open-vela/contest2026_438_baimi/evidence/IMG20260917205952.jpg

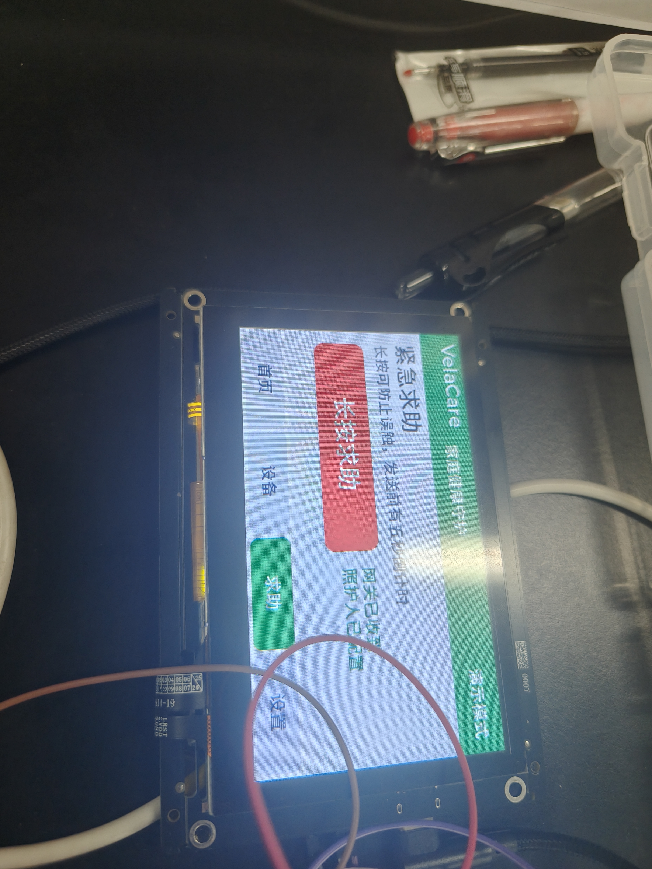
evidence/IMG20260917205952.jpg
