open-vela/contest2026_438_baimi/evidence/IMG20260917205958.jpg

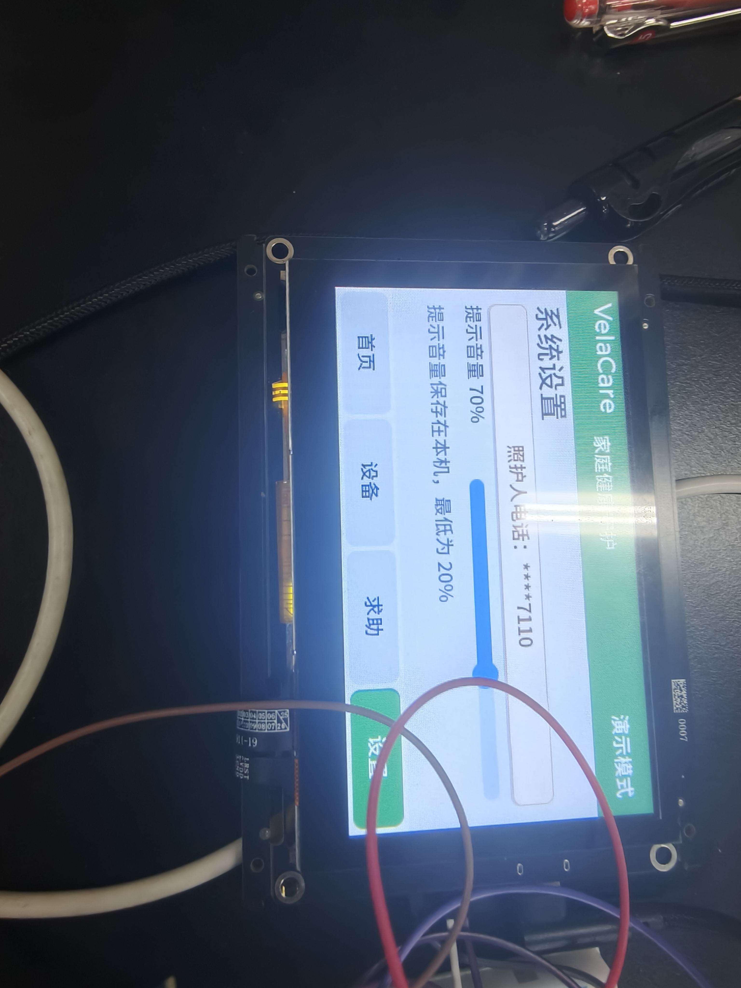
evidence/IMG20260917205958.jpg
