open-vela/contest2026_438_baimi/evidence/README.md

# 真机证据

这里只放少量实拍，避免把所有原图堆进仓库。

- `IMG20260916125602.jpg` — ESP32 与喇叭/传感器接线
- `IMG20260917205952.jpg`、`IMG20260917205958.jpg` — D12X 求助/设置相关实拍
- `Snipaste_2026-08-29_*.png` — 早期板卡界面，不是 9 月成品多角度照

完整系统接线、D12X 界面、传感器触发和网关联动过程已在演示视频中展示，链接见仓库根目录 `演示视频说明.md`。
