open-vela/contest2026_438_baimi/演示视频说明.md

# VelaCare 演示视频

## 📹 视频信息

- **文件名**：VelaCare_演示视频_Team438_baimi.zip
- **文件大小**：667.65 MB
- **格式**：MP4 (压缩包)
- **时长**：约 5 分钟
- **拍摄日期**：2026-09-19

## 🔗 下载链接

由于视频文件较大（667MB），超过 GitHub 单文件 100MB 限制，我们已将演示视频上传至百度网盘。

**百度网盘链接**：[https://pan.baidu.com/s/1Zz3T1Osgljr5gFPIG-S2Kg?pwd=6f4v](https://pan.baidu.com/s/1Zz3T1Osgljr5gFPIG-S2Kg?pwd=6f4v)

**提取码**：6f4v

## 📝 视频内容

演示视频完整展示了 VelaCare 家庭健康守护系统的以下功能：

### 1. 系统概览
- D12X 主界面展示
- 网关 Web 界面操作
- 系统架构说明

### 2. 传感器实时监测
- **门磁传感器**：门窗开关检测与告警
- **跌倒传感器**：老人跌倒检测（MPU-6500/9250 IMU）
- **水浸传感器**：漏水检测与提醒
- **烟雾传感器**：火灾隐患监测

### 3. 智能告警功能
- 多级告警机制（普通/严重/持续未恢复）
- D12X 界面实时状态显示
- 蜂鸣器声音告警
- **AI 语音播报**：跌倒事件智能语音提醒
- 网关远程监控与确认

### 4. 人性化设计
- 老人友好的大字体界面
- 一键求助功能
- 语音关怀与提醒
- 告警确认与静音

### 5. 真机运行
- 所有传感器实际触发演示
- ESP32-S3 + MAX98357A 音频播放
- D12X-DEMO68 实时响应
- 网络通信稳定性展示

## 🛠️ 技术亮点

- **OpenVela RTOS**：D12X 主板运行 VelaCare 应用
- **ESP32-S3**：网关核心，处理多传感器数据
- **AI 语音合成**：跌倒事件智能播报（MAX98357A 功放 + 喇叭）
- **实时通信**：UART + HTTP 双通道
- **多级告警**：普通提醒 → 严重告警 → 持续未恢复

## 📊 硬件配置

详见 [README 中的当前真机接线表](README.md#4-接线当前真机)

- D12X-DEMO68-V1.2 主板
- ESP32-S3-DevKitC 开发板
- MPU-6500/9250 六轴陀螺仪（跌倒检测）
- 门磁传感器、水浸传感器、烟雾传感器
- MAX98357A I2S 音频功放 + 4Ω 3W 喇叭

## 👥 团队信息

- **队伍名称**：baimi
- **队伍编号**：438
- **参赛分支**：dev-ai-contest-2026

---

**注意**：如链接失效或下载遇到问题，请联系团队成员或查看 GitHub Issues。
