open-vela/contest2026_438_baimi/docs/demo-video.md

# 演示视频

演示视频已于 2026-09-19 完成，时长约 5 分钟。因压缩包为 667.65 MB，超过 GitHub 单文件限制，已上传至百度网盘。下载链接、提取码和完整说明见[《VelaCare 演示视频说明》](../演示视频说明.md)。视频覆盖：

1. D12X 四页与适老按钮
2. 门磁开合、跌倒触发与恢复
3. 蜂鸣器、ESP32 中文语音、家人网页确认/静音
4. 老人确认安全后，界面仍保持真实告警
5. 自建 Skill 与 AI Coding 协作说明（短）

仓库不重复存放大体积视频压缩包。
