open-vela/contest2026_438_baimi/app/velacare/README.md

# app/velacare

openvela / NuttX 应用，PROGNAME=`velacare`。

启用选项：`CONFIG_LVX_USE_DEMO_CONTEST2026_438_VELACARE`

映射：`app/velacare` -> `packages/demos/contest2026_438_velacare`
