open-vela/contest2026_438_baimi/evidence/IMG20260916125602.jpg

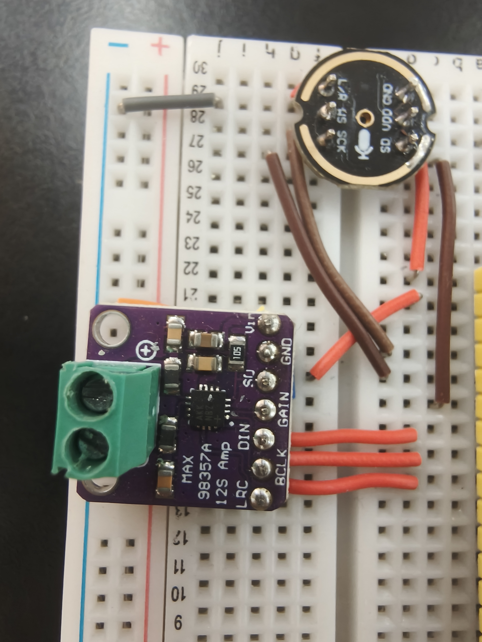
evidence/IMG20260916125602.jpg
