open-vela/contest2026_438_baimi/evidence/Snipaste_2026-08-29_14-42-14.png

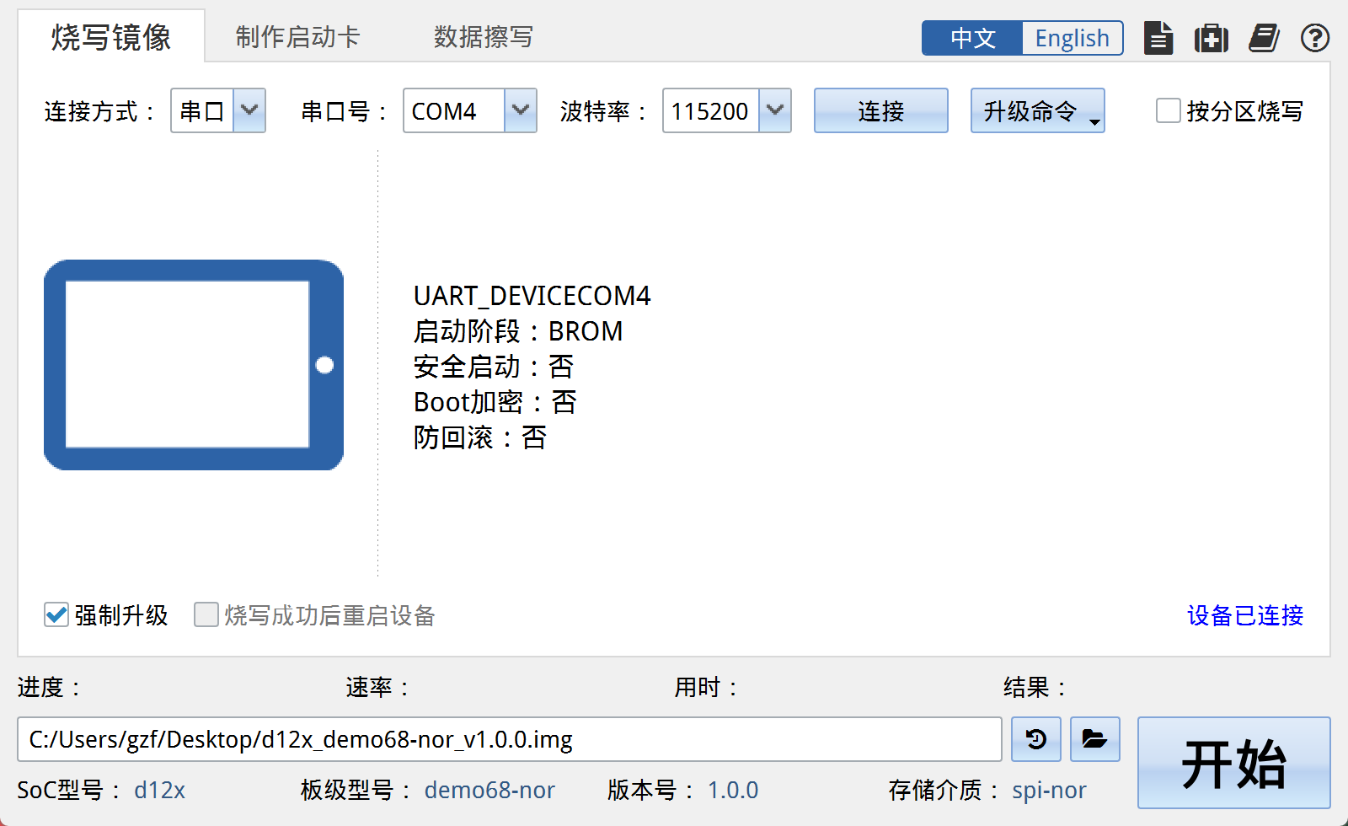
evidence/Snipaste_2026-08-29_14-42-14.png
