open-vela/contest2026_438_baimi/evidence/Snipaste_2026-08-29_17-33-11.png

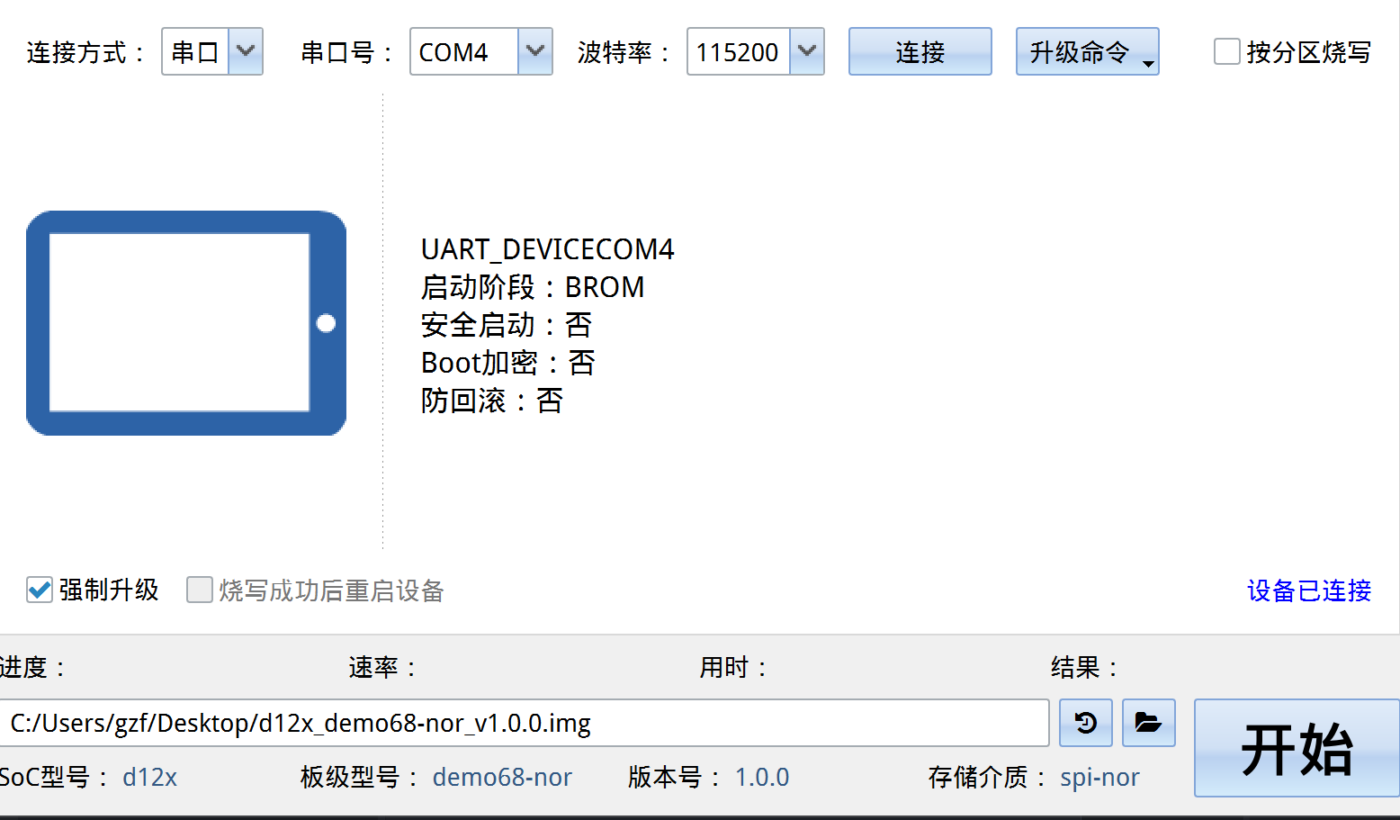
evidence/Snipaste_2026-08-29_17-33-11.png
