open-vela/contest2026_438_baimi/app/velacare/lv_font_velacare_cn_18.c

/*******************************************************************************
 * Size: 18 px
 * Bpp: 4
 * Opts: --bpp 4 --size 18 --font C:\Users\gzf\Desktop\open-vela\tmp\NotoSansSC-Medium.otf -r 0x20-0x7F --symbols ·…上不中亮人今仍以休会传住倒健先入全再准刚到前务动助危即及发可后听启告响器回在地声处备复天失好如守安完实家将小尚尽已帮常平并庭康开异当待很心快态急息您感成我或所打护报持按据接提撤收数整新无时显暂更有服未本条来查标检次正水求没测消漏烟照状现理用留登的监看真知确示离秒窗立等系紧线经给络统继续网置联自蜂行要言警认记设试请调败赶跌较运这连送通配里重量钮销门险雾需音页风首马鸣，： --format lvgl --lv-font-name lv_font_velacare_cn_18 -o C:\Users\gzf\Desktop\open-vela\tmp\v070-freeze-fix-src\app\velacare\lv_font_velacare_cn_18.c --no-compress --no-prefilter --force-fast-kern-format
 ******************************************************************************/

#ifdef LV_LVGL_H_INCLUDE_SIMPLE
#include "lvgl.h"
#else
#include "lvgl/lvgl.h"
#endif

#ifndef LV_FONT_VELACARE_CN_18
#define LV_FONT_VELACARE_CN_18 1
#endif

#if LV_FONT_VELACARE_CN_18

/*-----------------
 *    BITMAPS
 *----------------*/

/*Store the image of the glyphs*/
static LV_ATTRIBUTE_LARGE_CONST const uint8_t glyph_bitmap[] = {
    /* U+0020 " " */

    /* U+0021 "!" */
    0xf, 0xf1, 0xe, 0xf1, 0xe, 0xf0, 0xd, 0xf0,
    0xc, 0xf0, 0xc, 0xe0, 0xb, 0xe0, 0xa, 0xd0,
    0xa, 0xc0, 0x1, 0x20, 0x9, 0xb1, 0x3f, 0xf6,
    0xc, 0xd1,

    /* U+0022 "\"" */
    0x6f, 0xb0, 0x7f, 0xb5, 0xfb, 0x6, 0xfa, 0x4f,
    0xa0, 0x5f, 0x92, 0xf8, 0x3, 0xf7, 0x1f, 0x60,
    0x1f, 0x50, 0x93, 0x0, 0x92,

    /* U+0023 "#" */
    0x0, 0xa, 0x90, 0xe, 0x60, 0x0, 0xd, 0x70,
    0xf, 0x40, 0x0, 0xf, 0x50, 0x3f, 0x10, 0xe,
    0xff, 0xff, 0xff, 0xfa, 0x5, 0x8f, 0x65, 0xae,
    0x53, 0x0, 0x4f, 0x0, 0x8c, 0x0, 0x0, 0x6d,
    0x0, 0xaa, 0x0, 0x1, 0x8c, 0x11, 0xb9, 0x10,
    0x4f, 0xff, 0xff, 0xff, 0xf3, 0x14, 0xda, 0x44,
    0xf7, 0x41, 0x0, 0xe6, 0x1, 0xf3, 0x0, 0x0,
    0xf4, 0x3, 0xf1, 0x0, 0x2, 0xf2, 0x5, 0xf0,
    0x0,

    /* U+0024 "$" */
    0x0, 0x0, 0x8e, 0x0, 0x0, 0x0, 0x0, 0x8e,
    0x0, 0x0, 0x0, 0x1a, 0xff, 0xd7, 0x0, 0x0,
    0xef, 0xeb, 0xef, 0x80, 0x6, 0xfb, 0x0, 0x7,
    0x10, 0x7, 0xf8, 0x0, 0x0, 0x0, 0x4, 0xfe,
    0x20, 0x0, 0x0, 0x0, 0xaf, 0xf9, 0x10, 0x0,
    0x0, 0x5, 0xef, 0xe5, 0x0, 0x0, 0x0, 0x8,
    0xff, 0x60, 0x0, 0x0, 0x0, 0x5f, 0xd0, 0x0,
    0x0, 0x0, 0xf, 0xf0, 0x5, 0x80, 0x0, 0x4f,
    0xd0, 0xb, 0xff, 0xbb, 0xff, 0x50, 0x0, 0x6c,
    0xff, 0xc5, 0x0, 0x0, 0x0, 0x8e, 0x0, 0x0,
    0x0, 0x0, 0x8e, 0x0, 0x0,

    /* U+0025 "%" */
    0x1, 0xae, 0xd5, 0x0, 0x0, 0xd, 0x60, 0x0,
    0x0, 0xbd, 0x48, 0xf3, 0x0, 0x6, 0xd0, 0x0,
    0x0, 0x2f, 0x60, 0xe, 0xa0, 0x1, 0xe5, 0x0,
    0x0, 0x4, 0xf3, 0x0, 0xbc, 0x0, 0x8c, 0x0,
    0x0, 0x0, 0x4f, 0x30, 0xb, 0xc0, 0x2f, 0x30,
    0x0, 0x0, 0x2, 0xf5, 0x0, 0xda, 0xa, 0xa0,
    0x6d, 0xe9, 0x0, 0xc, 0xc1, 0x5f, 0x43, 0xf1,
    0x5f, 0x74, 0xe9, 0x0, 0x2d, 0xff, 0x80, 0xc8,
    0xb, 0xc0, 0x7, 0xf0, 0x0, 0x1, 0x0, 0x5e,
    0x0, 0xe9, 0x0, 0x4f, 0x20, 0x0, 0x0, 0xd,
    0x60, 0xe, 0x90, 0x5, 0xf2, 0x0, 0x0, 0x7,
    0xd0, 0x0, 0xbc, 0x0, 0x7f, 0x0, 0x0, 0x1,
    0xe4, 0x0, 0x5, 0xf7, 0x4e, 0x90, 0x0, 0x0,
    0x9b, 0x0, 0x0, 0x6, 0xde, 0x90, 0x0,

    /* U+0026 "&" */
    0x0, 0x4, 0xcf, 0xd4, 0x0, 0x0, 0x0, 0x3,
    0xfe, 0x8d, 0xf1, 0x0, 0x0, 0x0, 0x9f, 0x30,
    0x6f, 0x40, 0x0, 0x0, 0xa, 0xf1, 0x9, 0xf1,
    0x0, 0x0, 0x0, 0x6f, 0x69, 0xf8, 0x0, 0x0,
    0x0, 0x0, 0xff, 0xf6, 0x0, 0x0, 0x10, 0x0,
    0x8f, 0xfa, 0x0, 0x0, 0xef, 0x0, 0xaf, 0xbb,
    0xf7, 0x0, 0x4f, 0x90, 0x3f, 0xe0, 0xd, 0xf8,
    0xd, 0xf2, 0x5, 0xfa, 0x0, 0x1c, 0xfe, 0xf7,
    0x0, 0x2f, 0xe1, 0x0, 0x1e, 0xff, 0x60, 0x0,
    0xaf, 0xfa, 0xae, 0xfb, 0xef, 0xe3, 0x0, 0x6c,
    0xfd, 0xb4, 0x1, 0x8d, 0x0,

    /* U+0027 "'" */
    0x6f, 0xb5, 0xfb, 0x4f, 0xa2, 0xf8, 0x1f, 0x60,
    0x93,

    /* U+0028 "(" */
    0x0, 0x6, 0x10, 0x5, 0xf4, 0x0, 0xdc, 0x0,
    0x4f, 0x50, 0xa, 0xf0, 0x0, 0xec, 0x0, 0x1f,
    0x90, 0x4, 0xf6, 0x0, 0x5f, 0x50, 0x5, 0xf4,
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
    0x0, 0xdf, 0x20, 0x0, 0x0, 0x8e, 0xfb, 0xf6,
    0x0, 0x9, 0xff, 0xc0, 0x0, 0x0, 0x2, 0xef,
    0xf7, 0x0, 0x8f, 0x96, 0xfa, 0x0, 0x4, 0x9f,
    0xe6, 0x9d, 0x3c, 0xfa, 0x0, 0xaf, 0xc1, 0xe,
    0xe8, 0x10, 0x0, 0x9f, 0x70, 0x0, 0x8, 0xd1,
    0x1, 0x0, 0x0, 0x0, 0x12, 0x0, 0x0, 0x0,
    0x0,

    /* U+6574 "整" */
    0x0, 0x0, 0x8f, 0x0, 0x0, 0xc, 0x80, 0x0,
    0x0, 0xe, 0xff, 0xff, 0xff, 0xf3, 0x4f, 0x81,
    0x11, 0x10, 0x3, 0x44, 0xaf, 0x44, 0x40, 0xbf,
    0xff, 0xff, 0xf0, 0x6, 0xff, 0xff, 0xff, 0xd8,
    0xfe, 0x32, 0xec, 0x20, 0x6, 0xe0, 0x8f, 0x8,
    0xee, 0xcf, 0x86, 0xf5, 0x0, 0x6, 0xff, 0xff,
    0xff, 0xd2, 0x6, 0xfe, 0xc0, 0x0, 0x0, 0x19,
    0xff, 0xd8, 0x10, 0x2, 0xff, 0x70, 0x0, 0x2,
    0xbf, 0xbf, 0x5e, 0x91, 0x7f, 0xec, 0xfa, 0x30,
    0xe, 0xd3, 0x8f, 0x1, 0x2c, 0xfa, 0x10, 0x7f,
    0xe1, 0x2, 0x66, 0x89, 0x66, 0x68, 0x86, 0x66,
    0x67, 0x30, 0x0, 0xef, 0xff, 0xff, 0xff, 0xff,
    0xff, 0xff, 0x0, 0x0, 0x1, 0x31, 0x0, 0xdc,
    0x0, 0x0, 0x0, 0x0, 0x0, 0x4, 0xf4, 0x0,
    0xdf, 0xff, 0xff, 0xa0, 0x0, 0x0, 0x4, 0xf4,
    0x0, 0xdd, 0x55, 0x55, 0x30, 0x0, 0x6, 0x69,
    0xf9, 0x66, 0xee, 0x66, 0x66, 0x66, 0x60, 0x1f,
    0xff, 0xff, 0xff, 0xff, 0xff, 0xff, 0xff, 0xf1,
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
