open-vela/contest2026_438_baimi/app/velacare/lv_font_velacare_cn_28.c

/*******************************************************************************
 * Size: 28 px
 * Bpp: 4
 * Opts: --bpp 4 --size 28 --font C:\Users\gzf\Desktop\open-vela\tmp\NotoSansSC-Medium.otf -r 0x20-0x7F --symbols ·…上不中亮人今仍以休会传住倒健先入全再准刚到前务动助危即及发可后听启告响器回在地声处备复天失好如守安完实家将小尚尽已帮常平并庭康开异当待很心快态急息您感成我或所打护报持按据接提撤收数整新无时显暂更有服未本条来查标检次正水求没测消漏烟照状现理用留登的监看真知确示离秒窗立等系紧线经给络统继续网置联自蜂行要言警认记设试请调败赶跌较运这连送通配里重量钮销门险雾需音页风首马鸣，： --format lvgl --lv-font-name lv_font_velacare_cn_28 -o C:\Users\gzf\Desktop\open-vela\tmp\v070-freeze-fix-src\app\velacare\lv_font_velacare_cn_28.c --no-compress --no-prefilter --force-fast-kern-format
 ******************************************************************************/

#ifdef LV_LVGL_H_INCLUDE_SIMPLE
#include "lvgl.h"
#else
#include "lvgl/lvgl.h"
#endif

#ifndef LV_FONT_VELACARE_CN_28
#define LV_FONT_VELACARE_CN_28 1
#endif

#if LV_FONT_VELACARE_CN_28

/*-----------------
 *    BITMAPS
 *----------------*/

/*Store the image of the glyphs*/
static LV_ATTRIBUTE_LARGE_CONST const uint8_t glyph_bitmap[] = {
    /* U+0020 " " */

    /* U+0021 "!" */
    0xc, 0xff, 0x60, 0xcf, 0xf6, 0xb, 0xff, 0x50,
    0xbf, 0xf5, 0xa, 0xff, 0x40, 0xaf, 0xf3, 0x9,
    0xff, 0x30, 0x8f, 0xf2, 0x8, 0xff, 0x10, 0x7f,
    0xf1, 0x7, 0xff, 0x0, 0x6f, 0xf0, 0x5, 0xff,
    0x0, 0x5f, 0xe0, 0x3, 0xba, 0x0, 0x0, 0x0,
    0x2, 0x86, 0x1, 0xef, 0xf9, 0x4f, 0xff, 0xe2,
    0xff, 0xfc, 0x7, 0xed, 0x30,

    /* U+0022 "\"" */
    0x8f, 0xfc, 0x0, 0x5f, 0xff, 0x7f, 0xfc, 0x0,
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
    0xad, 0xff, 0xff, 0xff, 0xff, 0xfb, 0x10, 0x0,
    0x0, 0xe, 0xf9, 0x1f, 0xff, 0xff, 0xff, 0xeb,
    0x85, 0x20, 0x0, 0x0, 0x77, 0x78, 0xff, 0x90,
    0xef, 0xeb, 0x85, 0x10, 0x0, 0x0, 0x0, 0x0,
    0xa, 0xff, 0xff, 0xf5, 0x3, 0x10, 0x0, 0x0,
    0x0, 0x0, 0x0, 0x0, 0x0, 0x5f, 0xfe, 0xb6,
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
