open-vela/contest2026_438_baimi/app/velacare/velacare_cron.h

/****************************************************************************
 * apps/velacare/velacare_cron.h — 定时任务接口
 ****************************************************************************/

#ifndef __APPS_VELACARE_VELACARE_CRON_H
#define __APPS_VELACARE_VELACARE_CRON_H

void velacare_cron_init(void);

#endif
