open-vela/contest2026_438_baimi/app/velacare/velacare_skill.h

/****************************************************************************
 * apps/velacare/velacare_skill.h — Skill 装载接口
 ****************************************************************************/

#ifndef __APPS_VELACARE_VELACARE_SKILL_H
#define __APPS_VELACARE_VELACARE_SKILL_H

void velacare_skill_init(void);

#endif
