open-vela/contest2026_438_baimi/tools/test_velacare_protocol_v080.py

#!/usr/bin/env python3
"""VelaCare D12X/ESP32 host protocol regression (business sources are read-only)."""
from __future__ import annotations

import argparse
import copy
import hashlib
import re
from dataclasses import dataclass, field
from pathlib import Path
from typing import Callable, Dict, List, Optional, Sequence, Tuple

HERE = Path(__file__).resolve().parent
ROOT = HERE.parents[1]
REPORT = HERE / "PROTOCOL_AUDIT_20260918.md"
PATHS = {
    "D12X sensor": ROOT / "tmp/v070-freeze-fix-src/app/velacare/velacare_sensor.c",
    "D12X header": ROOT / "tmp/v070-freeze-fix-src/app/velacare/velacare_sensor.h",
    "D12X settings": ROOT / "tmp/v070-freeze-fix-src/app/velacare/velacare_settings.c",
    "D12X settings header": ROOT / "tmp/v070-freeze-fix-src/app/velacare/velacare_settings.h",
    "D12X LVGL": ROOT / "tmp/v070-freeze-fix-src/app/velacare/velacare_lvgl.c",
    "D12X LVGL header": ROOT / "tmp/v070-freeze-fix-src/app/velacare/velacare_lvgl.h",
    "D12X main": ROOT / "tmp/v070-freeze-fix-src/app/velacare/velacare_main.c",
    "ESP32 gateway": ROOT / "esp32_velacare_gateway/esp32_velacare_gateway.ino",
}

FAMILY_NOTIFICATION_CAPACITY = 12


def crc16(data: bytes) -> int:
    crc = 0xFFFF
    for byte in data:
        crc ^= byte << 8
        for _ in range(8):
            crc = ((crc << 1) ^ 0x1021) & 0xFFFF if crc & 0x8000 else (crc << 1) & 0xFFFF
    return crc


def make_frame(body: str) -> str:
    return f"{body}*{crc16(body.encode('ascii')):04X}\n"


def parse_frame(raw: str) -> str:
    found = re.fullmatch(r"([^*\r\n]+)\*([0-9A-Fa-f]{4})\r?\n?", raw)
    if not found:
        raise ValueError("malformed frame")
    body, check = found.groups()
    if crc16(body.encode("ascii")) != int(check, 16):
        raise ValueError("CRC mismatch")
    return body


class IdAllocator:
    """Persisted high-water allocator; no persistence means no request ID."""
    def __init__(self, nv: Optional[Dict[str, int]] = None, seed: int = 0x43800000):
        if nv is None:
            raise OSError("request-ID persistence unavailable")
        self.nv = nv
        first = self.nv.get("next", 0) or ((seed & 0x7FFFFFFF) | 0x10000000)
        self.next, self.limit = first, first + 256
        self.nv["next"] = self.limit

    def take(self) -> int:
        if self.next >= self.limit:
            self.next = self.nv["next"]
            self.limit = self.next + 256
            self.nv["next"] = self.limit
        value, self.next = self.next, self.next + 1
        assert value != 0
        return value
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
