open-vela/contest2026_438_baimi/(commit log)

2026-09-20 VelaCare v0.8.0 family-care + ESP32 v0.15.1 提交
    - D12X 老人端源码 app/velacare
    - ESP32 网关源码 gateway/esp32_velacare_gateway
    - 自建开发 Skill skills/velacare-dev
    - 真实 AI 日志 logs/gouzhongfei (12.9 MB, 10 会话)
    - 中文技术报告 docs/
    - 真机照片 evidence/
    - 串口协议与烧录工具 tools/
    当前可演示：四路传感器、双锚点跌倒、静音不改真值、ESP32 语音、家人网页。
    没有做：板端 MiMo / ai_agent。跌倒是原型。视频 9/19 补拍。
2026-09-20 添加演示视频说明文档（百度网盘链接）
2026-09-20 docs: complete final contest submission materials
